gemc/detectors/eic/field/det1_solenoid_dual_v2_fieldBz.png

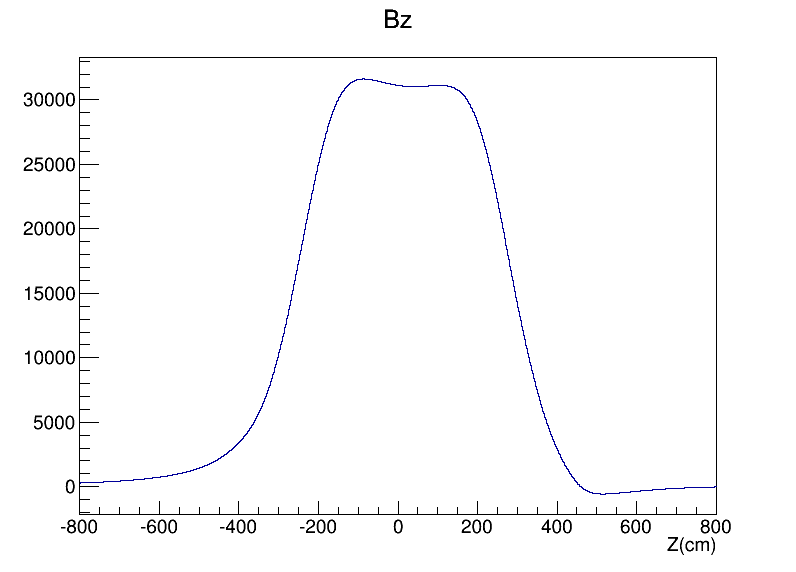
eic/field/det1_solenoid_dual_v2_fieldBz.png
