gemc/detectors/eic/field/det1_solenoid_dual_v2_fieldmap.png

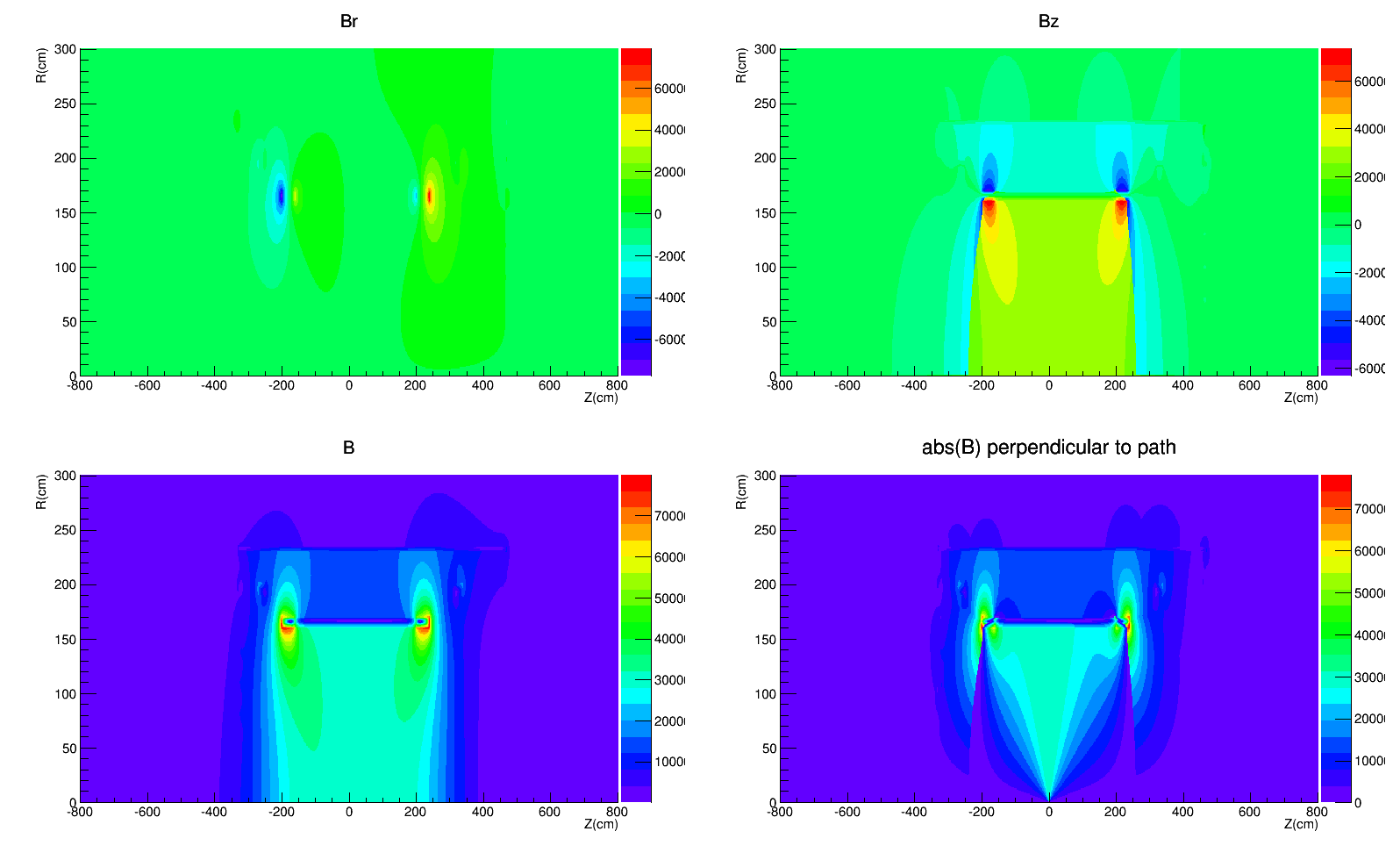
eic/field/det1_solenoid_dual_v2_fieldmap.png
