gemc/detectors/eic/field/det1_solenoid_dual_v9_fieldBz.png

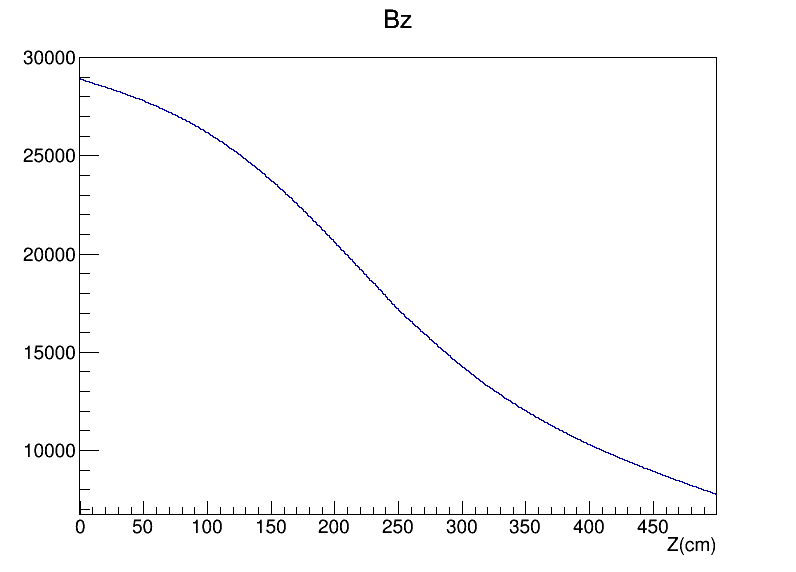
eic/field/det1_solenoid_dual_v9_fieldBz.png
