gemc/detectors/eic/field/det1_solenoid_dual_v9_fieldmap_log.png

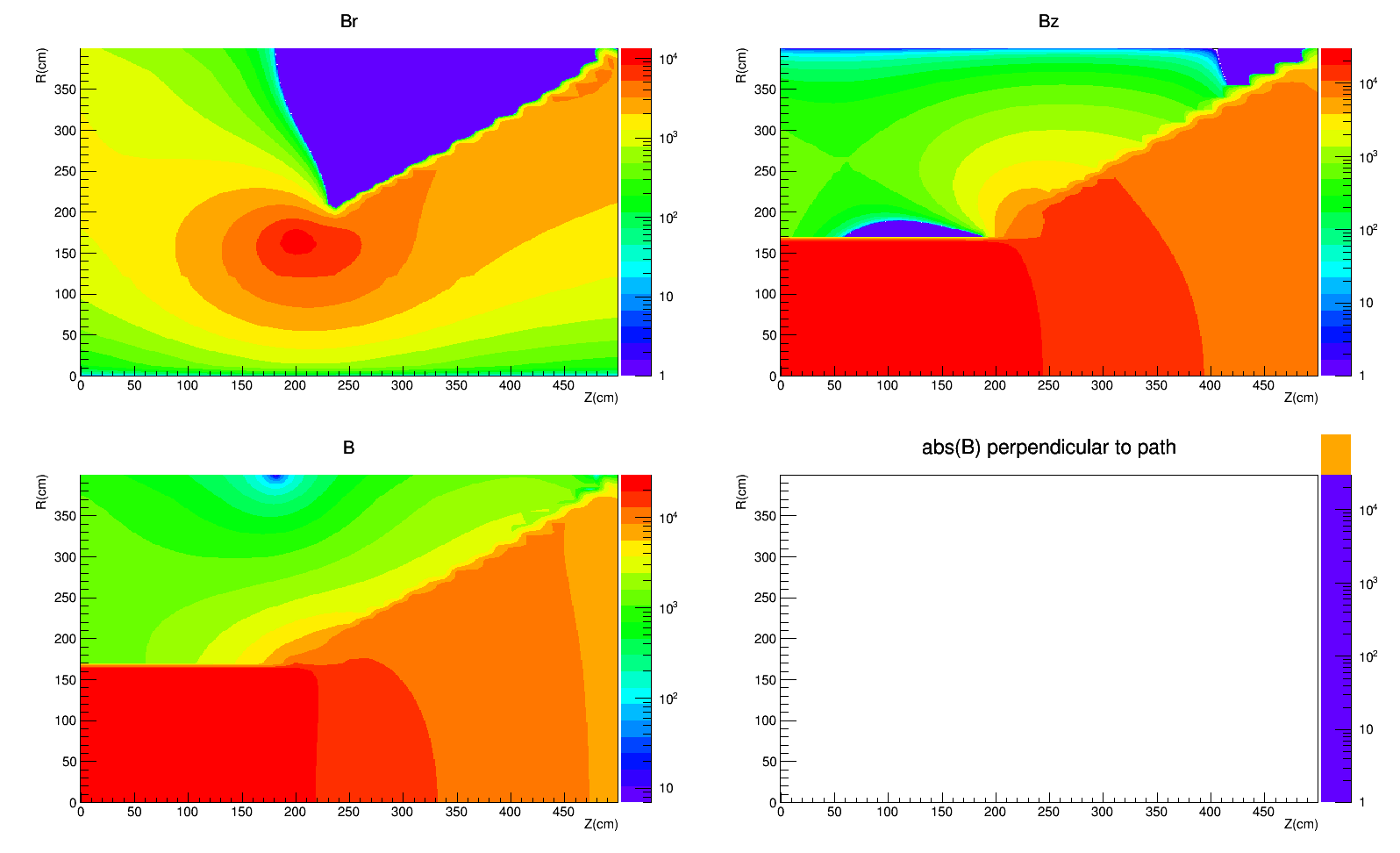
eic/field/det1_solenoid_dual_v9_fieldmap_log.png
