gemc/detectors/eic/field/det1_solenoid_hybrid_v1_fieldmap.png

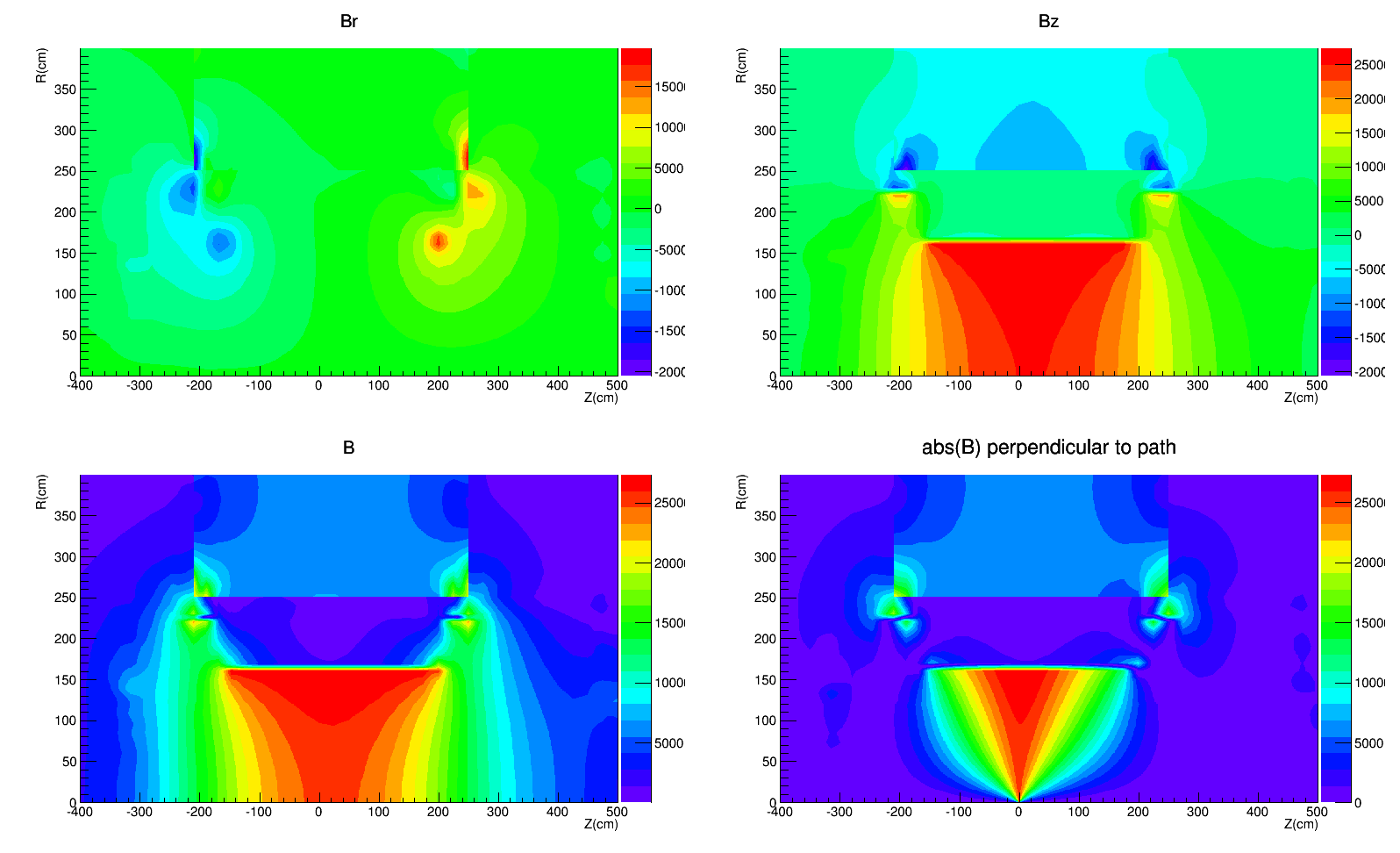
eic/field/det1_solenoid_hybrid_v1_fieldmap.png
