gemc/detectors/eic/field/det1_solenoid_hybrid_v1_fieldmap_log.png

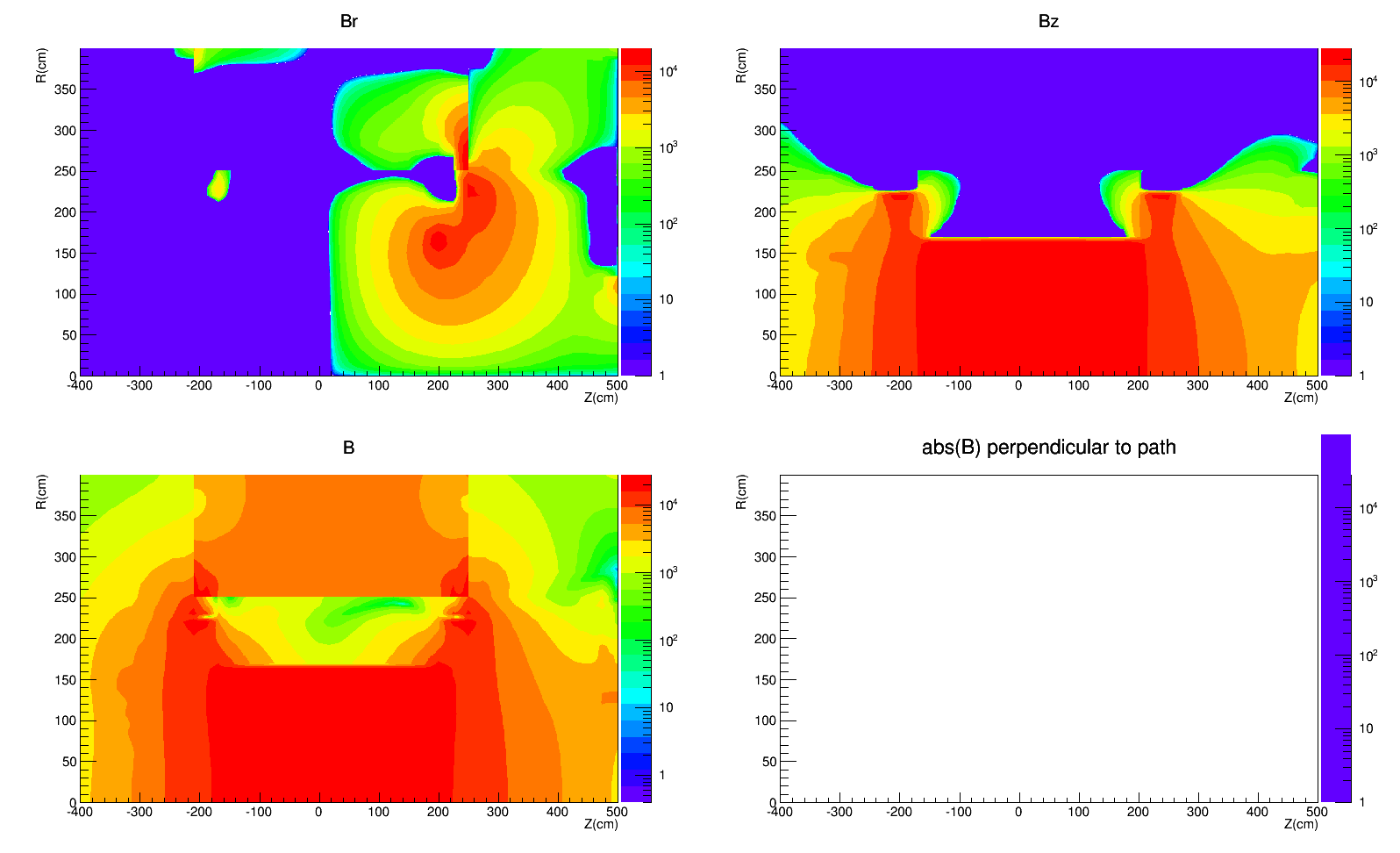
eic/field/det1_solenoid_hybrid_v1_fieldmap_log.png
