gemc/detectors/basic_examples/2_Working_with_materials/ex2_1_simple_det_materials/README.txt

#=======================================
#	README simple_det	materials
#=======================================

This folder contains one of the simplest possible projects:  a simple material in a beam. 
This simple case is used to show different ways of defining materials in gemc.  Unless using
a predefined GEANT4 element or NIST material directly in the detector definition, there will 
be a materials text file generated by materials.py for input to gemc.

The GEANT4 material database can be found at:
http://geant4.web.cern.ch/geant4/UserDocumentation/UsersGuides/ForApplicationDeveloper/html/apas06.html

The example should be able to run directly in gemc with the provided text input files and  the gcard option file using the command:
	gemc.command example.gcard

The example should be able to run directly in gemc with the provided text input files and  the gcard option 
file using the command:
	gemc.command example.gcard

If one wants to generate the text input files from the provided python scripts, the location of the python api files should be added to the PYTHONPATH. If installing via the DMG, add the following path for gemc-2.6:
export PYTHONPATH=$PYTHONPATH:/Applications/gemc-2.6.app/gemc.app/Contents/Resources/api/python
Adjust version number for a different gemc version

When this is done, generate the project files using:
	./example.py config.dat
WARNING:  this will overwrite the original project text files.
