gemc/detectors/basic_examples/3_Working_with_geometry/ex3_2_parameters_and_variations/ctof__materials_green.txt

        scintillator  |    ctof scintillator material  |     1.032  |         2  |                                          C 9 H 10  | none  | none  | none  | none  | none  | none  | none  |   -1  |   -1  |   -1  |   -1  |   -1  | none  
        scintillator  |    ctof scintillator material  |     1.032  |         2  |                                          C 9 H 10  | none  | none  | none  | none  | none  | none  | none  |   -1  |   -1  |   -1  |   -1  |   -1  | none  
        scintillator  |    ctof scintillator material  |     1.032  |         2  |                                          C 9 H 10  | none  | none  | none  | none  | none  | none  | none  |   -1  |   -1  |   -1  |   -1  |   -1  | none
