gemc/detectors/eic/geometry/det1_rich_dual_ionside/det1_rich_dual_ionside__materials_Original.txt

MAT_det1_rich_dual_ionside_aerogel  |     eic rich aerogel material  |      0.02  |         2  |                                          Si 1 O 2  |2*eV 2.5*eV 3*eV 3.5*eV 4*eV 7*eV  |1.02 1.02 1.02 1.02 1.02 1.02  |30*cm 30*cm 30*cm 30*cm 30*cm 30*cm  | none | none | none | none |-1  |-1  |-1  |-1  |-1  | none
             acrylic  |        eic rich lens material  |      1.19  |         3  |                                       C 5 H 8 O 2  |2.034*eV 3.181*eV 4.136*eV 4.13281*eV 6.19921*eV  |1.4902 1.5017 1.5017 1.5017 1.590  |5*cm 4.5*cm 4*mm 1*mm 0*mm  | none | none | none | none |-1  |-1  |-1  |-1  |-1  | none
           acrylic_a  |        eic rich lens material  |      1.19  |         3  |                                       C 5 H 8 O 2  |1.87855*eV 1.96673*eV 2.05490*eV 2.14308*eV 2.23126*eV 2.31943*eV 2.40761*eV 2.49579*eV 2.58396*eV 2.67214*eV 2.76032*eV 2.84849*eV 2.93667*eV 3.02485*eV 3.11302*eV 3.20120*eV 3.28938*eV 3.37755*eV 3.46573*eV 3.55391*eV 3.64208*eV 3.73026*eV 3.81844*eV 3.90661*eV 3.99479*eV 4.08297*eV 4.17114*eV 4.25932*eV 4.34750*eV 4.43567*eV 4.52385*eV 4.61203*eV 4.70020*eV 4.78838*eV 4.87656*eV 4.96473*eV 5.05291*eV 5.14109*eV 5.22927*eV 5.31744*eV 5.40562*eV 5.49380*eV 5.58197*eV 5.67015*eV 5.75833*eV 5.84650*eV 5.93468*eV 6.02286*eV 6.11103*eV 6.19921*eV  |1.4902 1.4907 1.4913 1.4918 1.4924 1.493 1.4936 1.4942 1.4948 1.4954 1.496 1.4965 1.4971 1.4977 1.4983 1.4991 1.5002 1.5017 1.5017 1.5017 1.5017 1.5017 1.5017 1.5017 1.5017 1.5017 1.5017 1.5017 1.5017 1.5017 1.5017 1.5017 1.5017 1.5017 1.5017 1.5017 1.5017 1.5017 1.5017 1.5017 1.5017 1.5017 1.5017 1.5017 1.5017 1.5017 1.5017 1.5017 1.5017 1.5017  |14.8495*cm 14.8495*cm 14.8495*cm 14.8495*cm 14.8495*cm 14.8495*cm 14.8495*cm 14.8495*cm 14.8495*cm 14.8495*cm 14.8495*cm 14.8495*cm 14.8495*cm 14.8495*cm 14.8495*cm 14.8495*cm 14.8495*cm 14.8494*cm 14.8486*cm 14.844*cm 14.8198*cm 14.7023*cm 14.1905*cm 12.3674*cm 8.20704*cm 3.69138*cm 1.33325*cm 0.503627*cm 0.23393*cm 0.136177*cm 0.0933192*cm 0.0708268*cm 0.0573082*cm 0.0483641*cm 0.0420282*cm 0.0373102*cm 0.033662*cm 0.0307572*cm 0.0283899*cm 0.0264235*cm 0.0247641*cm 0.0233451*cm 0.0221177*cm 0.0210456*cm 0.0201011*cm 0.0192627*cm 0.0185134*cm 0.0178398*cm 0.0172309*cm 0.0166779*cm  | none | none | none | none |-1  |-1  |-1  |-1  |-1  | none
MAT_det1_rich_dual_ionside_gas  |                  eic rich gas  |  0.005734  |         2  |                                           C 2 F 6  |2*eV 2.5*eV 3*eV 3.5*eV 4*eV 4.5*eV 5*eV 5.5*eV 6*eV 6.5*eV 7*eV  |1.000823 1.000823 1.000823 1.000823 1.000823 1.000823 1.000823 1.000823 1.000823 1.000823 1.000823  |10*m 10*m 10*m 10*m 10*m 10*m 10*m 10*m 10*m 10*m 10*m  | none | none | none | none |-1  |-1  |-1  |-1  |-1  | none
