gemc/detectors/eic/geometry/det1_beamline_pipe/det1_beamline_pipe__materials_Original.txt

det1_beamline_pipe_BeAl  |       det1_beamline_pipe_BeAl  |      2.16  |         2  |                             G4_Be 0.65 G4_Al 0.35  | none  | none  | none  | none  | none
