gemc/detectors/basic_examples/2_Working_with_materials/ex2_1_simple_det_materials/example__materials_original.txt

        scintillator  |         scintillator material  |     1.032  |         2  |                                          C 9 H 10  | none  | none  | none  | none  | none  | none  | none  |   -1  |   -1  |   -1  |   -1  |   -1  | none  
               water  |                water material  |     1.000  |         2  |                                           H 2 O 1  | none  | none  | none  | none  | none  | none  | none  |   -1  |   -1  |   -1  |   -1  |   -1  | none  
              my_air  |                  homemade air  |  0.001290  |         2  |                                 G4_N 0.7 G4_O 0.3  | none  | none  | none  | none  | none  | none  | none  |   -1  |   -1  |   -1  |   -1  |   -1  | none  
           my_lucite  |        plexiglass with optics  |      1.19  |         1  |                                 G4_PLEXIGLASS 1.0  |1.77*eV 6.2*eV  |1.5 1.5  | none  | none  | none  | none  | none  |   -1  |   -1  |   -1  |   -1  |   -1  | none
