gemc/detectors/basic_examples/4_Optical_properties/ex4_1_scintillation/example__materials_original.txt

              EJ_232  |Eljen Technologies EJ-232 plastic scintillator  |     1.032  |         2  |                                          C 9 H 10  |1.0*eV 2.0*eV 4.0*eV 6.0*eV  |1.40 1.40 1.40 1.40  |1000.*m 1000.*m 1000.*m 1000.*m  |0.5 0.5 0.5 0.5  |0.2 0.2 0.2 0.2  |0.8 0.8 0.8 0.8  |0.05 0.05 0.05 0.05  |8400.  |  2.0  |0.35*ns  |1.6*ns  |  0.8  | none
