gemc/detectors/basic_examples/4_Optical_properties/ex4_2_cerenkov_radiation/example__materials_original.txt

               water  |                 optical water  |      none  |         1  |                                        G4_WATER 1  |1.0*eV 6.0*eV  |1.33 1.33  |25.*m 25.*m  | none  | none  | none  | none  |   -1  |   -1  |   -1  |   -1  |   -1  | none
