gemc/detectors/basic_examples/4_Optical_properties/ex4_3b_optical_skin_surface/example__materials_original.txt

               glass  |                   pyrex glass  |      2.23  |         1  |                                  G4_Pyrex_Glass 1  |1.0*eV 6.0*eV  |1.47 1.47  | none  | none  | none  | none  | none  |   -1  |   -1  |   -1  |   -1  |   -1  | none  
      mirror_coating  |                mirror coating  |      2.70  |         1  |                                           G4_Al 1  |1.0*eV 6.0*eV  |1.2 1.2  | none  |0.97 0.97  | none  | none  | none  |   -1  |   -1  |   -1  |   -1  |   -1  | none  
              vacOpt  |vacuum with optical properties  |      none  |         1  |                                   G4_Galactic 1.0  |1.0*eV 6.0*eV  |1.00 1.00  |1000.*m 1000.*m  | none  | none  | none  | none  |   -1  |   -1  |   -1  |   -1  |   -1  | none
