gemc/detectors/basic_examples/4_Optical_properties/ex4_3c_optical_border_surface/example__materials_original.txt

              EJ_232  |Eljen Technologies EJ-232 plastic scintillator  |     1.032  |         2  |                                          C 9 H 10  |1.0*eV 2.0*eV 4.0*eV 6.0*eV  |1.0 1.0 1.0 1.0  |1000.*m 1000.*m 1000.*m 1000.*m  |0.5 0.5 0.5 0.5  |0.2 0.2 0.2 0.2  |0.8 0.8 0.8 0.8  |0.05 0.05 0.05 0.05  |8400.  |  2.0  |0.35*ns  |1.6*ns  |  0.8  | none  
              vacOpt  |vacuum with optical properties  |      none  |         1  |                                   G4_Galactic 1.0  |1.0*eV 6.0*eV  |1.00 1.00  |1000.*m 1000.*m  | none  | none  | none  | none  |   -1  |   -1  |   -1  |   -1  |   -1  | none  
              EJ_510  |EJ-510 TiO white reflective paint, Eljen Technologies  |       1.3  |         4  |                      Ti 6.71 C 11.2 H 22.5 O 19.0  |0.01*eV 60.0*eV  |2.7 2.7  |10.*m 10.*m  |1.0 1.0  |1.0 1.0  | none  | none  |   -1  |   -1  |   -1  |   -1  |   -1  | none
