gemc/detectors/atlas/cad/TRT.stl

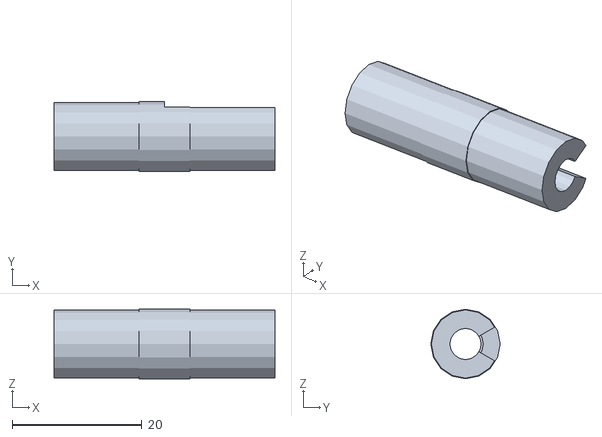
[picture p10: CAD file, 2016-07-22]
atlas/cad/TRT.stl
34.0 x 10.7 x 10.7
