gemc/detectors/clas12/ltcc/cad_cone/WC_L.stl

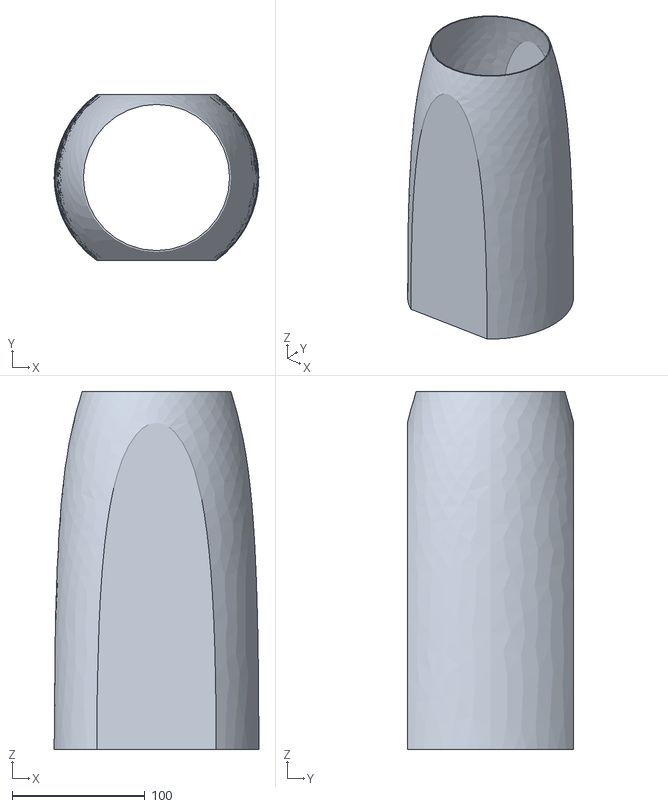
[picture p11: CAD file, 2017-02-22]
clas12/ltcc/cad_cone/WC_L.stl
154.0 x 125.1 x 269.4
