gemc/detectors/forFun/cad/enterprise.stl

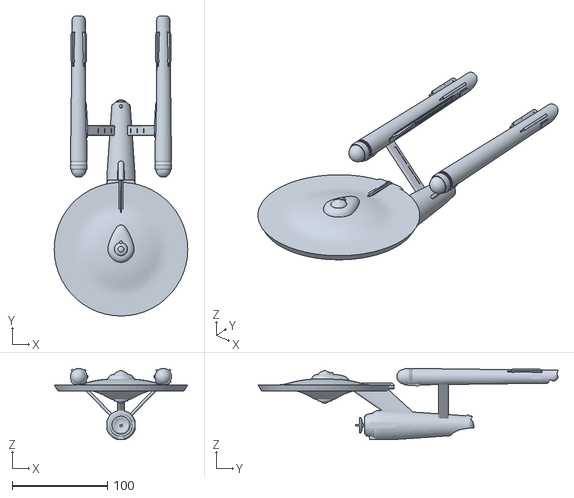
[picture p12: CAD file, 2016-07-22]
forFun/cad/enterprise.stl
140.0 x 314.4 x 74.7
