gemc/detectors/humanBody/cad/brain.stl

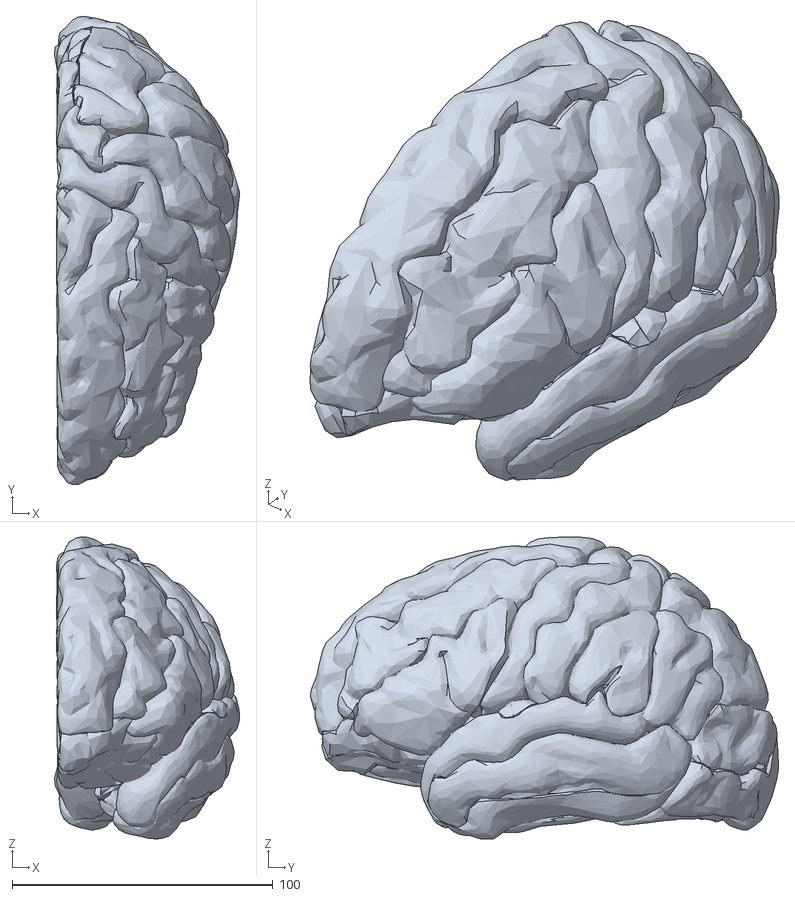
[picture p13: CAD file, 2016-07-22]
humanBody/cad/brain.stl
71.0 x 179.6 x 115.8
