gemc/detectors/atlas/cad/LargeOuterWheel.stl

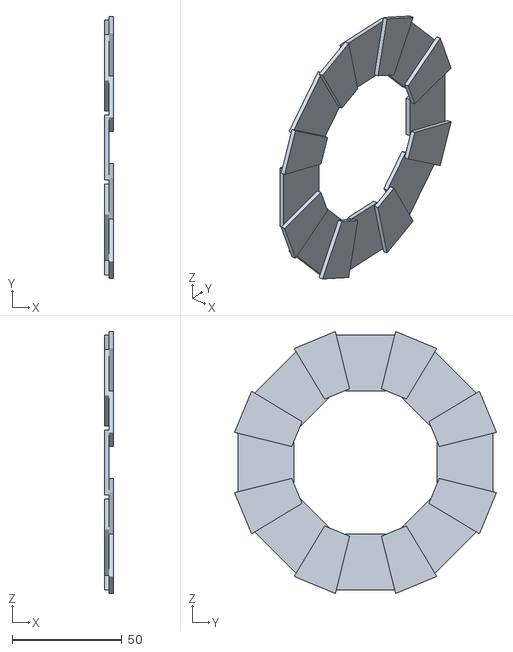
[picture p14: CAD file, 2016-07-22]
atlas/cad/LargeOuterWheel.stl
4.00 x 119.3 x 119.3
