gemc/detectors/forFun/cad/truck.stl

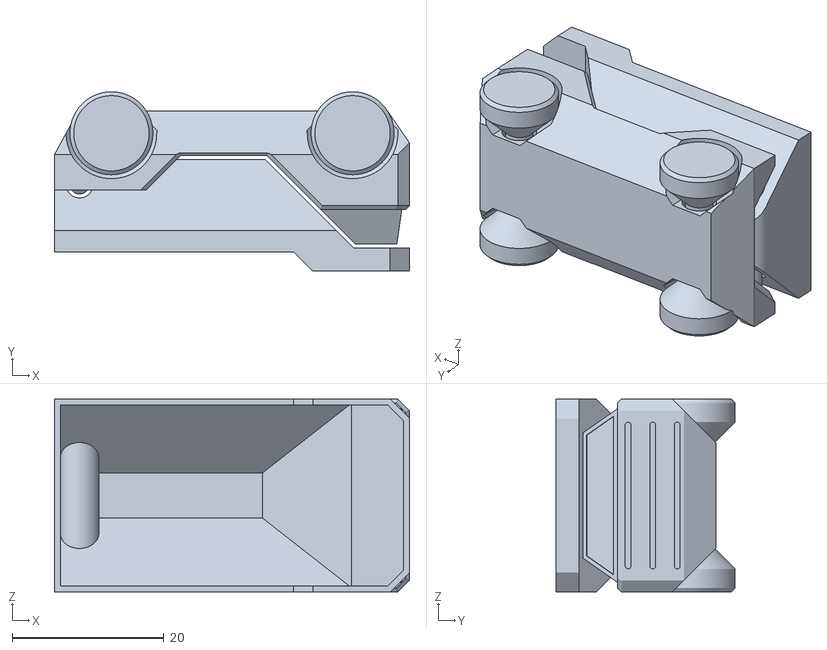
[picture p15: CAD file, 2016-07-22]
forFun/cad/truck.stl
46.7 x 23.6 x 25.4
