gemc/detectors/humanBody/cad/Lower_GI.stl

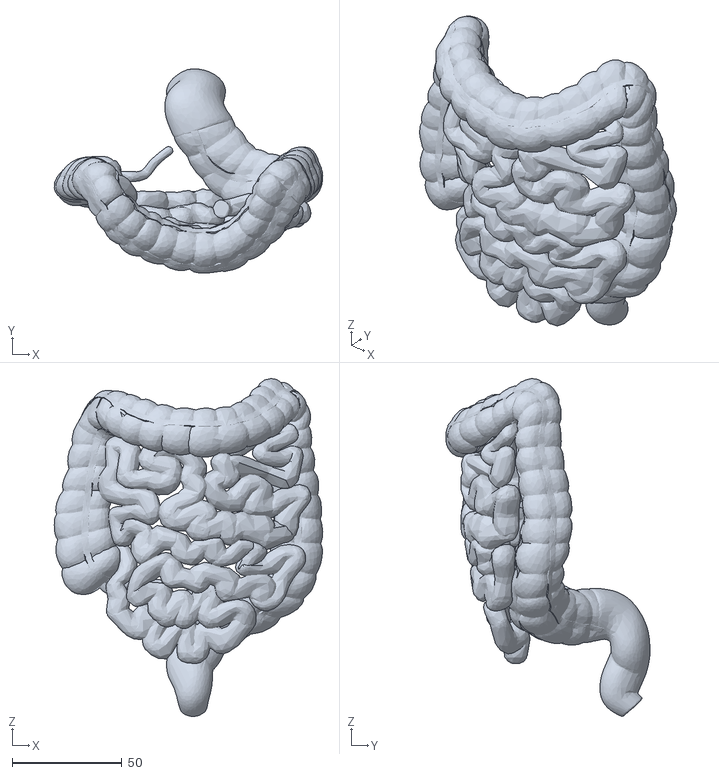
[picture p16: CAD file, 2016-07-22]
humanBody/cad/Lower_GI.stl
122.1 x 92.8 x 153.7
