gemc/detectors/atlas/cad/ForwardShield.stl

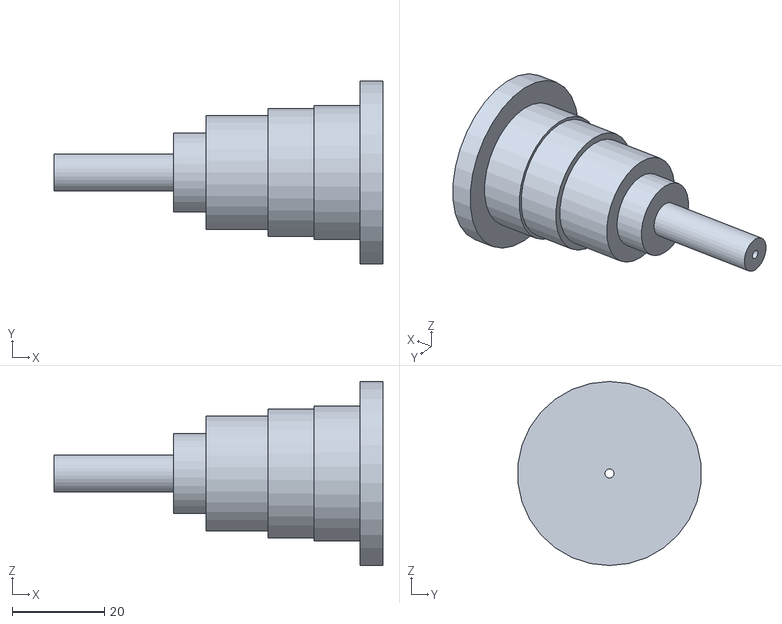
[picture p17: CAD file, 2016-07-22]
atlas/cad/ForwardShield.stl
71.5 x 39.8 x 40.0
