gemc/detectors/clas12/ltcc/cad_cone/WC_S_L11.stl

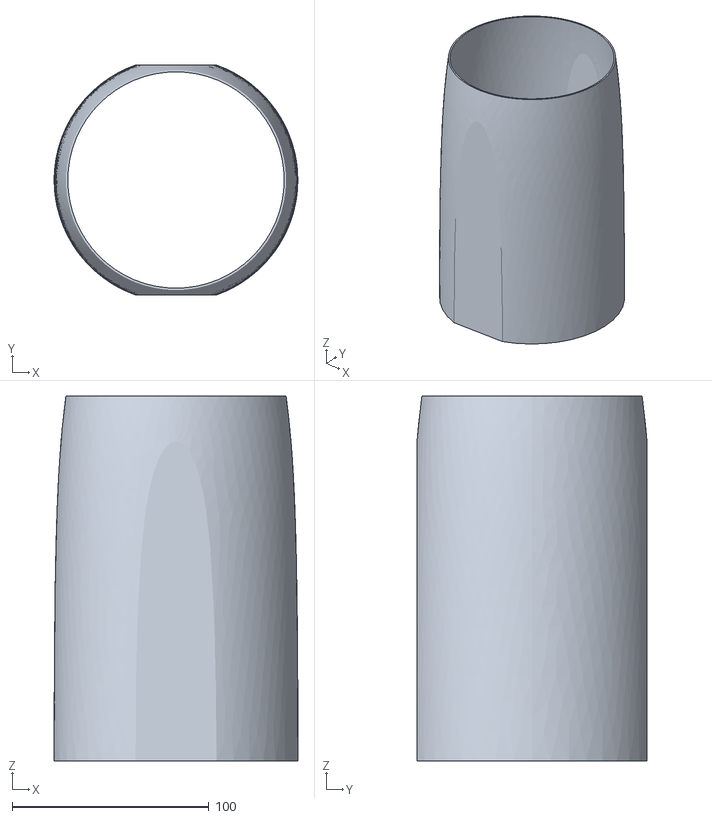
[picture p18: CAD file, 2017-02-22]
clas12/ltcc/cad_cone/WC_S_L11.stl
124.0 x 117.0 x 185.6
