gemc/detectors/forFun/cad/dragon.stl

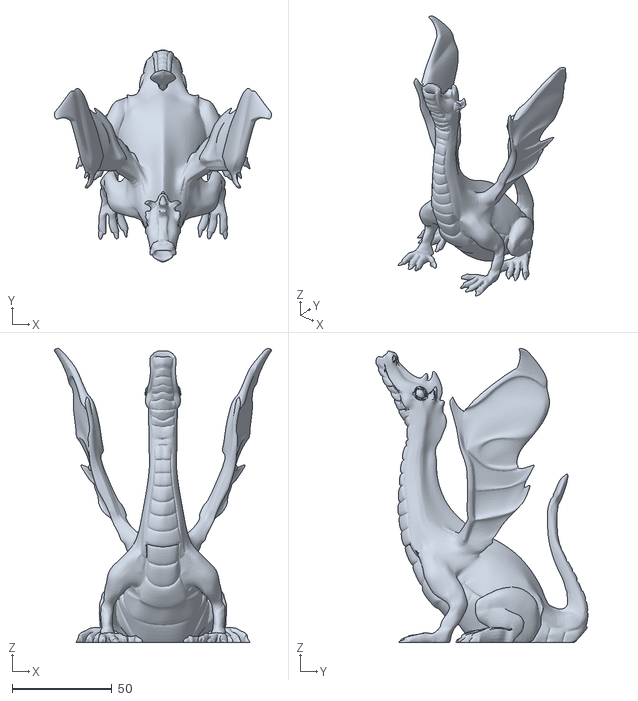
[picture p19: CAD file, 2016-07-22]
forFun/cad/dragon.stl
108.8 x 106.3 x 147.2
