gemc/detectors/humanBody/cad/Upper_GI.stl

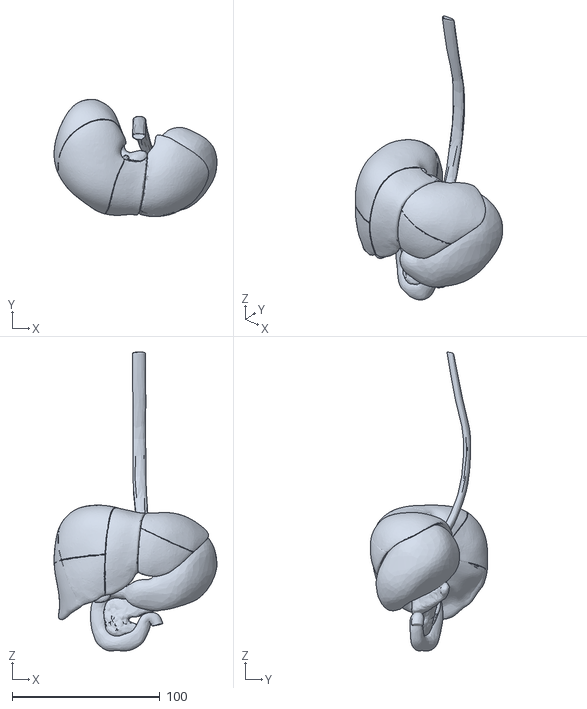
[picture p20: CAD file, 2016-07-22]
humanBody/cad/Upper_GI.stl
110.3 x 79.5 x 202.4
