gemc/detectors/atlas/cad/Toroid.stl

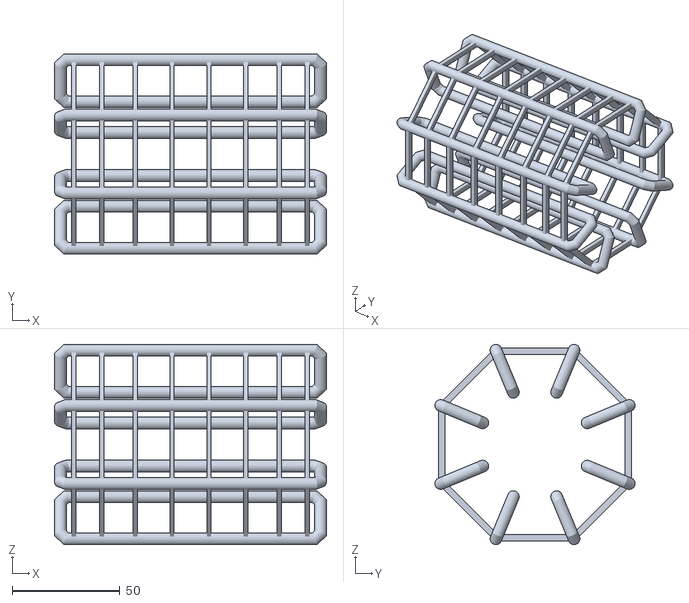
[picture p21: CAD file, 2016-07-22]
atlas/cad/Toroid.stl
126.3 x 93.0 x 93.0
