gemc/detectors/clas12/ltcc/cad_cone/WC_S_L111.stl

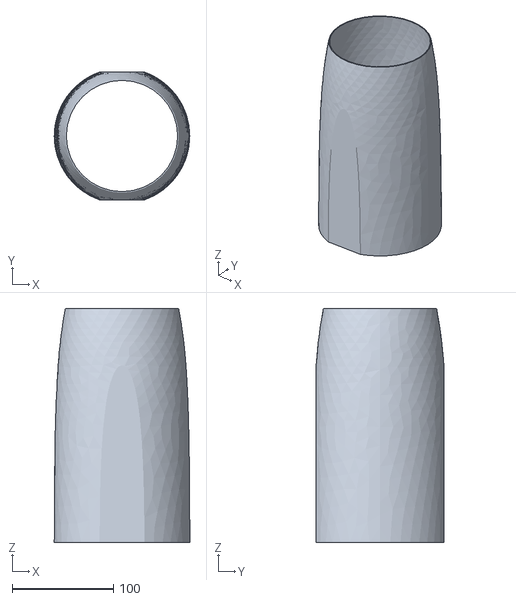
[picture p22: CAD file, 2017-02-22]
clas12/ltcc/cad_cone/WC_S_L111.stl
134.0 x 126.5 x 231.3
