gemc/detectors/humanBody/cad/heart.stl

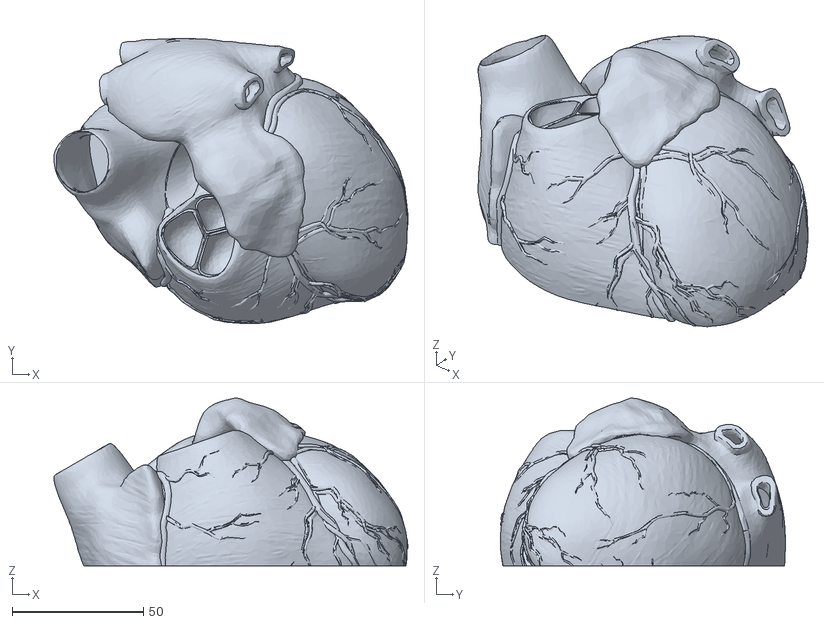
[picture p23: CAD file, 2016-07-22]
humanBody/cad/heart.stl
134.9 x 108.7 x 64.0
