gemc/detectors/atlas/cad/SmallBarrel.stl

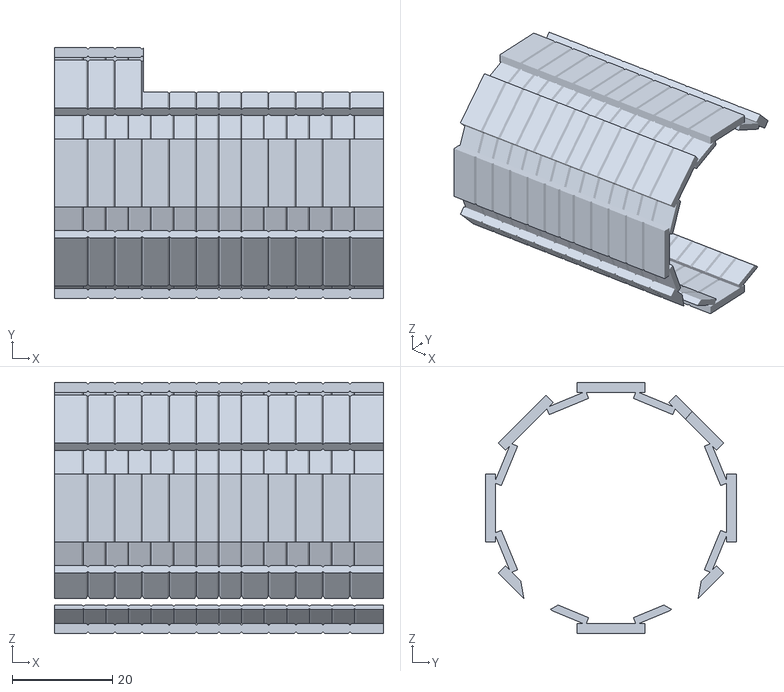
[picture p24: CAD file, 2016-07-22]
atlas/cad/SmallBarrel.stl
65.5 x 50.0 x 50.0
