gemc/detectors/atlas/cad/HEC.stl

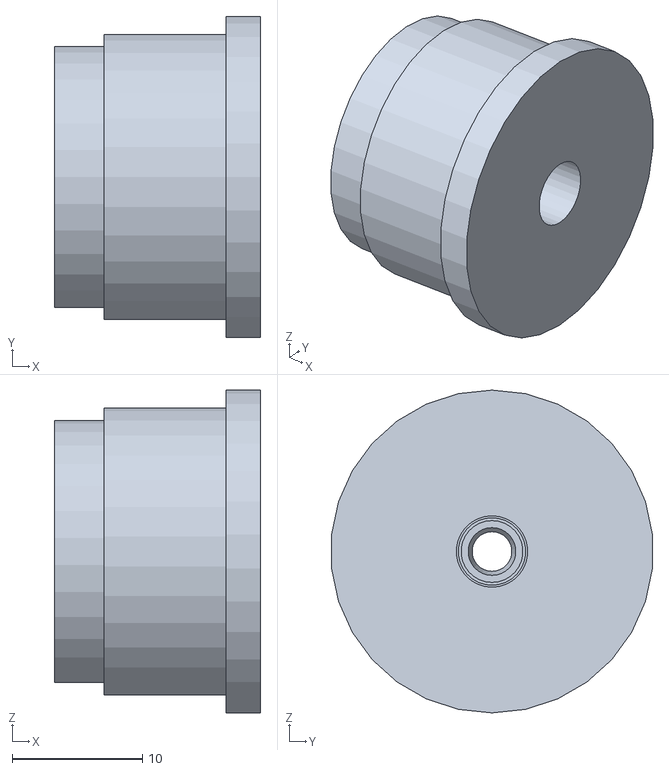
[picture p25: CAD file, 2016-07-22]
atlas/cad/HEC.stl
15.8 x 24.6 x 24.8
