gemc/detectors/(threads)

Thread 1 (2015-07-31):

EC Geometry bug?

forcar, 2015-07-31:
The attached plot shows a missing lead layer between the last two scintillators.  Also the last scintillator (39) does not follow the truncated pyramid geometry and looks almost identical to 38.  In between 38 and 39 there is no lead.  It may be the lead sequence is staggered upward since in EC there is no lead in front of the first scintillator.  I checked Gerry Gilfoyle's old talks and he had it correct in the original GEMC.
- Cole Smith

Addendum: Found bug in detectors/clas12/ec/geometry.pl in build_scintlayers subroutine where the loop index $i is not initialized to 1 for sectors 2-6.  This caused the first scintillator to be inserted with i=40, in effect putting scintillator 1 just below scintillator 39 as seen in the GEMC view (below, bottom).  This also explains why the average energy in the U strips was smaller than V or W since 20% of the energy was missing (plot just below left=U right=W).

I propose putting the statement "my $i = 1;" at line 368 in build_scintlayers.
- Cole Smith

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

maureeungaro, 2015-07-31:
Testing "New Issue" comments feature.

This looks like a bug in the geometry. Please modify as needed.

Closed 2015-08-02.

Thread 159 (2020-07-02):

ATOF and AHDC geometry implementation for A Low Energy Recoil Tracker (ALERT)

Viktoriya89, 2020-07-02:
This issue is to share the implementation of ALERT detector geometry. The detector consists of 2 parts: the hyperbolic drift chamber (AHDC) and time of flight scintillators (ATOF). Now, all active cells geometry is implemented. Any inert material structure can be added later using groovy or perl scripts.

maureeungaro, 2020-07-06:
merged

Closed 2020-07-06.

Thread 237 (2024-09-04):

overlap in the FMT geometry

raffaelladevita, 2024-09-04:
An overlap between layer1 and the mother volume is clearly visible in the rggf_spring2020 variation

maureeungaro, 2024-09-04:
making the mother volume 1.9 mm bigger fixes the mother volume overlap. However I see some additional overlaps , some quite significant like this one.

          Overlap is detected for volume FMT_outerPeek3:1 (G4Tubs)
          with FMT_Gas23:1 (G4Tubs) volume's
          local point (186.574,-40.8816,0.573267), overlapping by at least: 1.92673 mm

Will wait for Raffa's approval of the mother dimension increase. The other overlaps should be looked at by FMT group.

maureeungaro, 2024-09-04:
Increasing the gas volumes fixes these 'major' overlaps.  Some sub-microns overlaps persists but it may be geant4 precision issues of volumes very close together.

Thread 255 (2024-11-11):

Complete geometry vs run number for CLAS12 detectors

maureeungaro, 2024-11-11:

maureeungaro, 2024-11-14:
Pending CAD API  issue #250
