gemc/detectors/(commit log)

2015-07-31 ported detectors from svn
    [bst__parameters_original.txt, cnd__parameters_original.txt, ctof__parameters_original.txt, ec__parameters_original.txt, ftof__parameters_original.txt, geometry.parm, htcc__parameters_original.txt, micromegas__parameters_original.txt]
2015-08-28 Update micromegas__parameters_original.txt
    New geometry for fmt et bmt detectors
    [micromegas__parameters_original.txt]
2015-08-28 Update materials.pl
    update for new fmt and bmt geometry
2015-11-19 remove SL1,2,3 in gcard. production cut in hit. starting angle in geometry. no FMT in the perl script
    [micromegas__parameters_original.txt]
2015-11-24 added bubble setup
    [bubble__parameters_original.txt]
2015-11-24 started bubble template
    [bubble__parameters_original.txt]
2015-11-24 collimator + radiator added
    [bubble__parameters_original.txt]
2015-11-30 ”comment”
    [bubble__parameters_original.txt]
2015-12-01 Updated geometry
    [bubble__parameters_original.txt]
2015-12-02 added sensitivity, radiator flux detector, fixed radiator, addeed n2o inside chamber, added vacuum inside radiator
2015-12-16 Updated geometry, add LUMI event
    [bubble__parameters_original.txt]
2016-01-07 1/7/15 - added mount nose to torus - both phys and eng. design - draft of physicist design for shielding with and w/o FT finalized
2016-01-08 changes to forward carriage volume to accomodate dc volume growth for baseplates
2016-01-11 1/11/16 - torus is greatly simplified - some numbers will need some minor tweaks. - fixed overlaps with forward carriage volume as well
2016-01-14 added torus mount total length
2016-01-21 added dimension to missing first par of plates
2016-01-21 fixed vacuum beamline in case of FT
2016-01-22 mount dimensions modified according to Bob's email. mount outer shield added
2016-01-22 beampipe is 3.175mm thick up to the downstream torus nose end
2016-01-28 changed on 1/26/16: M. Mestayer. Fixed staggering. The first layer of sense wires (ilayer=1)
2016-01-29 modified FT "NotUsed..." variations removing tracker and added one beamline vacuum pipe variation with 50 mm OD for compatibility with ft NotUsedWithInnerShield
2016-01-29 improved scripts, added material to main script. added bst in gcard
2016-02-01 added bst.pl script to do geometry, material, banks and hits
2016-02-02 adding end plates, beamline macro, and doing materials changes
2016-02-02 formatting changes, and making all volumes solids instead of wireframe
2016-02-08 bst:
    - code clean ups
    cnd:
    - added cnd.pl script to do geometry, material, banks and hits
2016-02-08 - added ctof.pl script to do geometry, material, banks and hits - improved readmes for bst cnd ctof
2016-02-08 - more code clean up - added ec.pl script to do geometry, material, banks and hits
2016-02-08 - added ftof.pl script to do geometry, material, banks and hits
2016-02-11 new geometry and related scripts for Hall A dump and Catania setup for bg measurements
2016-02-11 2/11/16 - added htcc.pl script to do geometry, material, banks and hits
2016-02-11 - added pcal.pl script to do geometry, material, banks and hits
    [pcal__parameters_original.txt]
2016-02-29 - finalized micromegas.pl script to do geometry, material, banks and hits
2016-02-29 2/29/16 - added targets.pl script to do geometry, material, banks and hits - added elaborate geometry from omairsalam
2016-03-01 3/1/16 - added magnets.pl to build both solenoid and torus geometry - removed obsolete ftm as now it's inside FT
2016-03-04 adding Edep in bms digitization output
2016-03-07 - relaxing magnets.pl to accept one argument so it is consistent with the other scripts
2016-03-17 added root macros to check wire efficiency and smeearing
2016-04-04 only printing variations FTon/off
2016-04-04 print parameters values for position and rotation of panel Volumes
2016-04-05 added materials, crystal rotations
2016-04-08 removed par file
    [pcal__parameters_original.txt]
2016-04-08 replaced pars with the java version
    [ftof__parameters_original.txt]
2016-04-15 reducing additional radius on support and shield to avoid overlaps with the solenoid
2016-05-10 New version of the RICH geometry. It has the most updated information on geometry and position of the elements relevant for the direct-light case. # Please enter the commit message for your changes. 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
    [rich__parameters_original.txt]
2016-05-10 typo fo fc carriage name
2016-05-10 switch dc.gcard to java variation
2016-05-11 Added in geometry the files "frontal_system.pl" and "pmt.pl", that were missing in the previous stage.
2016-05-11 Fixed the name of "carbon fiber" in materials.pl - and reproduced the txt files.
2016-05-19 moved mucal at 60cm
2016-06-09 ftof loop over volumes is defined by perl script now
    [ftof__parameters_original.txt]
2016-06-10 ctof geometry changed to 48 paddles
    [ctof__parameters_original.txt]
2016-07-07 removed materials from cpp factory
2016-07-22 added cad and gdml example import. added atlas cad import example. added forFun example
    [ForwardShield.stl, HEC.stl, LargeOuterWheel.stl, SmallBarrel.stl, TRT.stl, Toroid.stl, dragon.stl, enterprise.stl]
2016-07-22 added human body example
    [Lower_GI.stl, Upper_GI.stl, brain.stl, heart.stl]
2016-07-28 7/28/16 - added cad directory with stl files for scintillators and light guides - added cad.gxml to assign sensitivity to the paddles. Positions / rotations from engineering frame added - modified hi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
    [lgd01.stl, lgd02.stl, lgd03.stl, lgd04.stl, lgd05.stl, lgd06.stl, lgd07.stl, lgd08.stl]
2016-07-28 added upstream light guides
    [lgu01.stl, lgu02.stl, lgu03.stl, lgu04.stl, lgu05.stl, lgu06.stl, lgu07.stl, lgu08.stl]
2016-07-28 two variations created, original and cad, so both can be used in the gcard
2016-08-09 getting local position in cad paddle
2016-08-22 michel garcon changes on BMT
    [micromegas__parameters_original.txt]
2016-09-02 Added sensor active zones and dead zones for SVT.
2016-09-02 BST: Added output of perl scripts for version "java".
    [bst__parameters_java.txt]
2016-09-12 added sensor active and dead zones still need to work out hit definition
2016-09-16 Removed sensor active and dead zones Added local copy of SVTGeometry-coatjava-2.4.jar v0.2.3
    [bst__parameters_java.txt]
2016-09-22 fix DC gcard typo CArriage->Carriage
2016-09-30 added cad model of the beamline
    [cone-tip.stl, flange-assembly.stl, inner-assembly.stl, innerShieldAndFlange.stl, lead-shield.stl, lifting-plate.stl, main-cone.stl, nut1.stl]
2016-10-05 moved cad.gxml in files directory
2016-10-06 FT inner shield and mount mesh fixed. It was STP format, new IGS used instead
    [TUNGSTEN_PIPE_MZ.igs, taggerInnerShield.stl]
2016-10-10 preserving original micromegas configuration
    [micromegas__parameters_michel.txt, micromegas__parameters_original.txt]
2016-10-10 moved cad into cadBeamline dir
2016-10-10 moved files into cad dir
    [Lower_GI.stl, Upper_GI.stl, brain.stl, dragon.stl, enterprise.stl, heart.stl, truck.stl]
2016-10-18 michel new files
    [micromegas__parameters_michel.txt]
2016-10-27 added new rotation angles about z axis for shields, updated WCs and pmts angles
2016-10-27 added smaller cylinders inside the pmts as light stoppers, fixed the segment number in identifier, changed the colors of shields and WCs
2016-11-14 backup for coatjava v2.4 version
    [bst__parameters_java.txt]
2016-11-21 GXML class and CTOF CAD import
2016-11-21 export primitives to STL files
2016-11-22 Final relabelling of CND sector-layer-components
    [cnd__parameters_original.txt]
2016-11-28 SVT: added passive materials to geometry_java.pl
    [bst__parameters_java.txt]
2016-11-28 SVT switched to all sectors and enabled modules
2016-12-05 latest geometry from Michel Garcon
    [micromegas__parameters_michel.txt]
2016-12-06 Fixed parameter file errors
    [cnd__parameters_original.txt]
2016-12-08 SVT fixed bug with pads
    [bst__parameters_java.txt]
2016-12-26 updated C4F10 CO2 and N2 optical paramters between 170 nm and 650 nm. Quartz pmt QE values are replaced with p-Terphenyl pmt QE values
2017-01-18 switch to coatjava 3.0
2017-01-23 PMTs, Winston Cones, Shields, Cylindrical mirrors are moved into the LTCC sectors. To fit the LTCC geometry into LTCC box shields have been shrunk and replaced to their correct positions (dz_d parame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
    [S1-BB.stl, S1-BLB.stl, S1-BRB.stl, S1-BW.stl, S1-LW.stl, S1-RW.stl, S1-TB.stl, S1-TLB.stl]
2017-02-14 switch DC to JCSG
2017-02-15 SVT switch to COATJAVA 3.0
2017-02-21 Winston cones were made in AUTOCAD and placed in the simulation. Code cleanep up. Calculations for positions and rotations are in geo_calculations.C script. Some parameters added/removed. It is essen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
    [WC_S_L11.stl, WC_S_L110.stl, WC_S_L111.stl, WC_S_L112.stl, WC_S_L113.stl, WC_S_L114.stl, WC_S_L115.stl, WC_S_L116.stl]
2017-02-28 cones are replaced in ltcc sectors, cone names are modified, geo_calculations script creates a tsv file that the variables' values are written on
    [WC_S1_L1.stl, WC_S1_L10.stl, WC_S1_L11.stl, WC_S1_L12.stl, WC_S1_L13.stl, WC_S1_L14.stl, WC_S1_L15.stl, WC_S1_L16.stl]
2017-03-08 copies of the cones were made
    [WC_L.stl, WC_M.stl, WC_S.stl, WC_S1_L10.stl, WC_S1_L12.stl, WC_S1_L14.stl, WC_S1_L15.stl, WC_S1_L16.stl]
2017-03-24 1st check into eic detector
    [det1_beamline_magnet__parameters_Original.txt, det1_compton_eledownstream__parameters_Original.txt, det1_tagger_eledownstream__parameters_Original.txt, ion_beam_env_ds_22jun16.xls, meic_v12_det_reg_elem.13dec13.xls, meic_v15d_det_reg_elem.10Jun15.xls, meic_v15d_det_reg_elem.12mar15.xls, meic_v15e_det_reg_elem.3Dec15.xls]
2017-04-12 fixed mirror sensitivity
    [ltcc__parameters_original.txt]
2017-05-05 Slight modifications of the bmt geometry
    [micromegas__parameters_michel.txt]
2017-05-08 organized cad.gxml files according to dir
2017-06-08 putting taggerInnerShield in the correct position (is a separate cad volume)
2017-06-20 fixed cad gxml with correct hierarchy. skipped the 3 original cones right copies
2017-06-27 Add adc info in FMT bank
2017-07-05 added torus cad files
    [Beamline.stl, BoreShield.stl, CenterTube.stl, DownstreamShieldingPlate.stl, DownstreamVacuumJacket.stl, Hub001.stl, Plate1.stl, Plate2.stl]
2017-07-05 using javacad instead of cad
    [lgd01.stl, lgd02.stl, lgd03.stl, lgd04.stl, lgd05.stl, lgd06.stl, lgd07.stl, lgd08.stl]
2017-07-05 added geometry including cads for clas12
    [lgd01.stl, lgd02.stl, lgd03.stl, lgd04.stl, lgd05.stl, lgd06.stl, lgd07.stl, lgd08.stl]
2017-07-05 no javacad, that one is created
    [lgd01.stl, lgd02.stl, lgd03.stl, lgd04.stl, lgd05.stl, lgd06.stl, lgd07.stl, lgd08.stl]
2017-07-05 remove files not needed, make some pipe visiable and hide some virtual planes
    [det1_compton_eledownstream__parameters_Original.txt]
2017-07-07 moving cad volumes for FTOFF in a separate directory
    [cone-tip.stl, flange-assembly.stl, inner-assembly.stl, innerShieldAndFlange.stl, lead-shield.stl, lifting-plate.stl, main-cone.stl, nut1.stl]
2017-07-07 copying the STL file instead of making links
    [flange-assembly.stl, innerShieldAndFlange.stl, lifting-plate.stl, main-cone.stl, nut1.stl, nut2.stl, nut3.stl, nut4.stl]
2017-07-07 fixing position for FTON
    [lifting-plate.stl]
2017-07-10 added DS torus shield
    [ShieldDSadapter.stl, ShieldDSlead.stl, ShieldDSleadbase.stl]
2017-07-10 added correct material for torus parts
2017-07-12 fixed materials for some cad volumes
2017-07-14 added adc variable
2017-08-08 created a new script for the frame
2017-08-09 deleted the unnecessary frame files since the copies are made
    [S2-BB.stl, S2-BLB.stl, S2-BRB.stl, S2-BW.stl, S2-LW.stl, S2-RW.stl, S2-TB.stl, S2-TLB.stl]
2017-08-09 added the subroutines for cones, cylindrical mirrors, frame and shields
2017-08-09 added the line to load cad files of the frame
2017-08-10 placed ltcc sector 15 cm downstream
2017-08-11 building LTCC frame not under comment anymore
2017-08-11 added clas8 bullet
    [downstreamTube.stl]
2017-08-14 frames are sst. No need for sector 3 as it's the one from CAD
2017-08-17 CTOF geometry mofidication * removed upstream lightguides * moved GXML as a module to api directory (it will be the same and used for multiple future CAD detectors, e.g. RICH)
2017-08-17 removed flange assembly. added apex volume
    [flange-assembly.stl]
2017-08-17 removed downstream tube
    [downstreamTube.stl]
2017-08-18 added new vacuum line. numbers to be finalized
    [apex.stl]
2017-08-18 removed obsolete cad models
    [Beamline.stl, ShieldDSadapter.stl, ShieldDSlead.stl, ShieldDSleadbase.stl]
2017-08-21 new apex from cyril. added lead inside apex
    [apex.stl]
2017-08-21 removing obsolete files
    [micromegas__parameters_original.txt]
2017-08-21 fixxed typo in material
2017-08-22 fixed ltcc frame mother to fc
2017-08-22 fixed cad frame mother to fc
2017-08-29 added target cad elements
    [TargetAlWindowD.stl, TargetAlWindowU.stl, TargetBaseTubeTorlon.stl, TargetEndCapKapton.stl, TargetFoam.stl, TargetFoam2.stl, TargetFoam3.stl, TargetVacuumTubeAl.stl]
2017-08-30 target from cad, embedded in vacuum container, lh2 cell
2017-08-30 smaller target enclosure. vacuum line in the shield starting 1mm downstream of target vac extension
2017-08-30 smaller target enclosure. vacuum line in the shield starting 1mm downstream of target vac extension; removed fton2 variation
2017-08-31 vacuum extension is carbon fiber. added material
2017-09-07 change in frame material
2017-09-11 materials are not transparent
2017-09-11 new target, no transparency in MM
    [TargetVacuumTubeAl.stl]
2017-09-20 added adjuster. retessalating step files
    [innerShieldAndFlange.stl, nut1.stl, nut2.stl, nut3.stl, nut4.stl, nut5.stl, nut6.stl, nut7.stl]
2017-09-20 added adjusters
    [adjuster1.stl, adjuster2.stl, adjuster3.stl]
2017-09-22 new stl file for FTOff configuration as well
    [innerShieldAndFlange.stl, nut1.stl, nut2.stl, nut3.stl, nut4.stl, nut5.stl, nut6.stl, nut7.stl]
2017-09-22 more precise inner shield
    [innerShieldAndFlange.stl]
2017-09-29 new stl for inner shield in tagger; moved outer flange upstream to avoide overlap with FC
    [taggerInnerShield.stl]
2017-09-29 step file backup up in another location
    [TUNGSTEN_PIPE_MZ.igs]
2017-10-10 added downstream element from CAD model. modifying vacuum line and adding connecting element from CAD model
    [DSShieldBackAss.stl, DSShieldBackCover.stl, DSShieldBackLead.stl, DSShieldFlange.stl, DSShieldFlangeAttachment.stl, DSShieldFrontAss.stl, DSShieldFrontCover.stl, DSShieldFrontLead.stl]
2017-10-12 added definitions for FTOff. Removed lifting plate and window support, not needed
    [lifting-plate.stl, windowSupportUpstreamPipe.stl]
2017-10-12 using latest FT Inner shield for OFF configuration as well
    [taggerInnerShield.stl]
2017-10-13 in FT, the hit time window is rised from 4ns to 400 ns, this is for account pileup in mode1 output, an in the ctof banks in the identifier a new element is added order which should define which PMT i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
2017-10-18 making FMT inner radius bigger to accomodate target
    [micromegas__parameters_michel.txt]
2017-11-02 un necesarry files are deleted
    [lgd01.stl, lgd02.stl, lgd03.stl, lgd04.stl, lgd05.stl, lgd06.stl, lgd07.stl, lgd08.stl]
2017-11-02 Secondary files from ftof are removed
    [ftof__parameters_java.txt]
2018-02-01 added several materials
2018-02-25 included materials for Run Group C Polarized Target (PolTarg)
2018-02-25 descritor file for CAD drawing
2018-02-25 Helium cooling liquid for Polarized target
    [LHeVolume_29.stl]
2018-02-25 PCTFE holder for target cells
    [InsertBath_6.stl]
2018-03-01 saving various changes for different materials
2018-03-02 fixed dc material
2018-03-20 Update rtpc.pl
    Changed z_half from 200 mm to 192 mm (4 total pads less).
2018-05-22 Add files via upload
    No Boid STL files
    [InsertBath_NoVoid_6.stl, LHeVolume_NoVoid_29.stl]
2018-06-07 update on micromegas geometry and 8-mm upstream shift for bmt and fmt
    [micromegas__parameters_michel.txt]
2018-07-03 added W shied 51 microns and neoprene shield 2.7mm outside of svt
2018-07-05 added LTCC nose from model
    [BottomPlate.stl, Epoxy.stl, FrontPlate.stl, Mount.stl, NFrame.stl, Nose.stl]
2018-07-23 added magnets and dc in the gcard
2018-10-09 fixing atlas example
    [ForwardShield.stl, HEC.stl, LargeOuterWheel.stl, SmallBarrel.stl, TRT.stl, Toroid.stl]
2018-10-30 added ctof shield configurations, 1,2,3 mm
2018-11-30 added 0.1 conf
    [TargetFoam.stl]
2018-12-03 front foam w/o the original nose
    [TargetFoam.stl]
2018-12-11 Delete LHeVolume_NoVoid_29.stl
    removed LHe Volume for now
    [LHeVolume_NoVoid_29.stl]
2018-12-11 Update cad.gxml
    commented out LHe volume
2019-02-24 Add files via upload
    Adding the necessary files to implement the EG2p nuclear targets assembly in gemc.
    [cellAlwindow.stl, cellendcap.stl, endcapAlwindow.stl, firstRohacellSpacer.stl, firsttargframe.stl, secondRohacellSpacer.stl, secondtargframe.stl, targetContainer.stl]
2019-03-03 old lh2 and ld2 to become obsolete, using cad model for those
2019-03-11 solenoid material is copper not iron
2019-07-03 added devel case for coatjava
2019-07-10 finalized ltcc variations for different run period. also fixed PMT thickness and mirrors materials
2019-07-10 rich sector 4 geometry added
    [Aluminum.stl, CFRP.stl, Layer_201_component_1.stl, Layer_201_component_10.stl, Layer_201_component_11.stl, Layer_201_component_12.stl, Layer_201_component_13.stl, Layer_201_component_14.stl]
2019-07-11 remove rich geometry txt files produced by geometry factory
    [Aluminum.stl, CFRP.stl, Layer_201_component_1.stl, Layer_201_component_10.stl, Layer_201_component_11.stl, Layer_201_component_12.stl, Layer_201_component_13.stl, Layer_201_component_14.stl]
2019-08-09 vacuum extension + target vacuum encompassing scattering chamber fix
2019-10-11 fixed material for vacuum
2019-12-11 non-working version of the BMT bonus variation
    [TargetAlWindowD.stl, TargetAlWindowU.stl, TargetBaseTubeTorlon.stl, TargetEndCapKapton.stl, TargetVacuumWindow50umAl.stl, TargetWallKapton.stl, TargetWindowAdapterTorlon.stl, foamExtended.stl]
2019-12-11 putting material routine inside the conf loop
2019-12-11 bonus variation for MM shifted back by 1.8 mm
    [micromegas__parameters_bonus.txt]
2019-12-13 Modifications of materials and geometry for BoNuS slim Micromegas version
    [micromegas__parameters_bonus.txt]
2019-12-18 bonus variation renamed to rgf_spring2020
    [micromegas__parameters_rgf_spring2020.txt]
2019-12-18 just comment
    [ftof__parameters_default.txt, ftof__parameters_rga_fall2018.txt]
2020-04-07 APOLLO target for RGC
    [InsertBath_NoVoid_6.stl]
2020-04-08 ELMO shield V1 no FT
    [DSShieldBackAss.stl, DSShieldBackCover.stl, DSShieldBackLead.stl, DSShieldFlange.stl, DSShieldFlangeAttachment.stl, DSShieldFrontAss.stl, DSShieldFrontCover.stl, DSShieldFrontLead.stl]
2020-05-18 magnet for polarized He3 target meshed using freecad, tessellation size: 0.2 mm surface deviation, standard method
    [MagnetPolHe3.stl]
2020-05-18 create a new directory for transversely polarized He3 target
    [InsertBath_NoVoid_6.stl, MagnetPolHe3.stl, TargetAlWindowD.stl, TargetAlWindowU.stl, TargetBaseTubeTorlon.stl, TargetEndCapKapton.stl, TargetFoam.stl, TargetFoam2.stl]
2020-05-20 add ttarget as target subsystem
    [InsertBath_NoVoid_6.stl, TargetAlWindowD.stl, TargetAlWindowU.stl, TargetBaseTubeTorlon.stl, TargetEndCapKapton.stl, TargetFoam.stl, TargetFoam2.stl, TargetFoam3.stl]
2020-07-02 ATOF and AHDC detector geometry for active cells, July 2020 by V. Sergeyeva
    [ahdc__parameters_default.txt, ahdc__parameters_rga_fall2018.txt, atof__parameters_default.txt, atof__parameters_rga_fall2018.txt, myatof__parameters_default.txt]
2020-07-21 nuclearTargetTest geo
    [TargetFoam.stl, TargetFoam2.stl, TargetFoam3.stl]
2020-07-22 added flux detector and finalized dimensions
    [TargetVacuumWindow50umAl.stl]
2020-07-26 upload all stl files for longitudinal target
    [MEOP_CLAS12.stp, al_window.stl, be.stl, beam_window.stl, deverter.stl, exchanger.stl, flow_entrance.stl, flow_entrance001.stl]
2020-07-26 target will be generated by gemc, not stl
    [he3.stl]
2020-07-27 adjust target location to -3 cm like rga-fall 2018
2020-07-27 create vacuum container around the target as mother volume, expect -3mm shift in z like as in rga fall 2018
2020-07-28 covering airgap to new scattering chamber configuration
2020-07-29 aluminium window by geometry.pl, no extension of mother volume, all daughter volumes enclosed by mother volume
    [al_window.stl, be.stl]
2020-07-30 use lH2's vacuum chamber
    [TargetFoam.stl, TargetFoam2.stl, TargetFoam3.stl, TargetVacuumWindow50umAl.stl, TargetWindowAdapterTorlon.stl]
2020-07-30 replace the approximate he3 part with the stl file
    [he3.stl]
2020-08-02 add root volume with magnetic field hdicefield
2020-08-06 MgB2 cylinder added, air pipe customized due to overlap
2020-08-15 modify hdIce up to current design
2020-09-03 update cad drawing of hdice
    [Target-for eHD-2015-12-22-for CLAS12 Simulation.stp, magnet.stl, target.stl, targetRing.stl, targetShellInner.stl, targetShellOuter.stl]
2020-09-03 replace target with stl file
2020-10-13 add ibc stl files, to be filtered later
2020-11-05 Removed band text files and added upstreamBeampipe.
    Conflicts:
    clas12/upstreamBeampipe/materials.pl
2020-12-21 hdIce target cad file updates
    [80KCan_Al.stl, 80KCan_SS.stl, LHeCan_Al.stl, LHeCan_Cu.stl, LHeCan_Nylon.stl, LHeCan_PCTFE.stl, LHeCan_SS.stl, Target-for eHD-2015-12-22-for CLAS12 Simulation.stp]
2021-01-19 bst bank def is inside variation loop
    [bst__parameters_java.txt, bst__parameters_original.txt]
2021-02-16 transverse target materials for rgh proposal
    [Transverse_target_for_simulation_20210212b.stp, cell.stl, ladder.stl, ladderSupport.stl, targetFrame.stl]
2021-02-18 transverse target geometry
    [Transverse_target_for_simulation.FCStd, Transverse_target_for_simulation.stp, Transverse_target_for_simulation_20210212b.stp, cell.stl]
2021-02-18 transverseTarget folder renamed include cad in name
    [Transverse_target_for_simulation.FCStd, Transverse_target_for_simulation.stp, downCoils.stl, downRing.stl, ladder.stl, ladderSupport.stl, magnetSupport.stl, targetFrame.stl]
2021-02-18 correct material and radii of transverse target
2021-02-22 transverse target correct materials
2021-02-24 material change in transverse target
2021-02-24 Update materials.pl
    Change bubble fluid from N2O to C3F8
2021-03-16 ALERT setup total geometryfor GEMC, 16 March 2021
    [atof__parameters_rga_fall2018.txt]
2021-03-29 one-piece scattering chamber and window position fix
    [TargetFoam.stl, TargetFoam2.stl, TargetFoam3.stl, scatteringChamber.stl]
2021-04-12 updated geometry of polarized target (APOLLO) and RG-C noFT (ELMO) Moller shield
    [InsertBath_NoVoid_6.stl]
2021-04-15 removed TargetWindowAdapterTorlon
    [TargetWindowAdapterTorlon.stl]
2021-06-30 size of mother to be a better envelope for the scattering chamber
2021-07-07 added beamline components
    [AdditionalWindows.FCStd, AdditionalWindows.stp, BeamPathExitWindow.stl, DownstreamRS.stl, InnerRSSheet.stl, InnerRSSheetMIR1.stl, Pumpline60mm.stl, UpstreamRS.stl]
2021-07-07 added materials in beam path for transverse field configuration. TransverseUpstreamBeampipe splitted in two to account for heat shield
    [AdditionalWindows.FCStd, AdditionalWindows.stp, BeamPathExitWindow.stl, DownstreamRS.stl, InnerRSSheet.stl, InnerRSSheetMIR1.stl, Pumpline60mm.stl, UpstreamRS.stl]
2021-08-19 New SLIM version for micromegas... Modified as well micromegas.pl to build bmt when slim version is called
    [micromegas__parameters_slim.txt]
2021-11-22 added mollerCup and entryDish for htcc
    [htccCone.stl, htccMollerCone.stl]
2021-11-23 added spring and fall2018 cad configurations
    [htccCone.stl, htccMollerCone.stl]
2021-12-09 added htcc moller cone extension, removed deprecated entry in elmo cad.gxml
    [htccMollerConeExt.stl]
2021-12-09 fixex htcc cad system of coordinates
2021-12-09 htcc cones with updated reference system
    [htccCone.stl, htccMollerCone.stl]
2022-02-18 added htcc entry / exit windows
    [htccCone.stl, htccMollerCone.stl, htccMollerConeExt.stl]
2022-02-18 added materials and entry exit windows. fixed positions of cad volumes
    [htccCone.stl, htccMollerCone.stl, htccMollerConeExt.stl]
2022-03-03 overlap fixes by Giovanni
    [RICH_s4.stl]
2022-03-16 removed upstream band material core file. updated band to include passive material. bank and hit updates for micromegas
2022-04-20 band bank for hipo and rich sector 4 cad.gxml was missing
2022-04-20 fixed missing bracket
2022-04-26 band gcard default output switched to hipo
2022-06-03 fixed ND3 target material and color
2022-06-29 fixed Cone2 Cylinder FTflangeShieldCylinder for rgh beamline
2022-07-25 erasing all txt files
    [ahdc__parameters_default.txt, ahdc__parameters_rga_fall2018.txt, atof__parameters_default.txt, atof__parameters_rga_fall2018.txt, myatof__parameters_default.txt]
2022-08-23 temp removing some cad import creating problems
    [BottomPlate.stl, Epoxy.stl, FrontPlate.stl, Mount.stl, NFrame.stl, Nose.stl, S1-BW.stl, S1-LW.stl]
2022-08-30 temp removed frame7
    [S1-TRB.stl]
2022-09-22 updated the geometry and materials of RG-F(BONuS12) RTPC and target variations
2022-10-14 Add cad target geometries specific to RG-M. Variation cadrgm removed upstream exit window and liquid target wall as not to conflict with solid target geometries.
    [TargetAlWindowU.stl, TargetBaseTubeTorlon.stl, TargetVacuumWindow50umAl.stl, scatteringChamber.stl]
2023-01-18 added volumes from cad
    [crystal_shell.stl, ddvcs_cal.FCStd, layout_calorimeter.stl, moeller_cone.stl]
2023-02-24 adding scatt chamber and target for ddvcs
2023-08-08 testing optics bug: stretched RICH_s4.stl in blender so that volume better contains optical components
    [RICH_s4.stl]
2023-08-08 fix overlap with ftof volume
    [RICH_s4.stl]
2023-08-14 Fixed the missing material of liquid Helium for the lHe target variation of the standard liquid target cell.
2023-08-21 Updated aerogel materials, now defined correctly for the two sectors + updated for sector 4
2023-08-25 define all mirror materials separately (currently all reflectivities the same, waiting for measurement tables from marco)
2023-10-20 native window cell, no cad
    [TargetAlWindowD.stl, TargetAlWindowU.stl]
2023-10-20 native scattering chamber cell, no cad
    [TargetVacuumWindow50umAl.stl]
2023-10-25 window placement from eng. numbers and adding additional barriers. mother target volume extended 8mm to accommodate for sc window
2023-10-25 moving scattering chamber 8mm upstream to play better with current airgap
2023-10-27 Some refactoring of geometry generation code to set number of sectors for each variation, rather than have a variation for each sector. New variations: default->two rich sectors, nominal positions; r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
2023-10-27 stop tracking rich_sector4
    [Aluminum.stl, CFRP.stl, Layer_201_component_1.stl, Layer_201_component_10.stl, Layer_201_component_11.stl, Layer_201_component_12.stl, Layer_201_component_13.stl, Layer_201_component_14.stl]
2023-11-02 fixed thicknesess of window materials
2023-11-08 Temporary change: copy corrected mother volume stl file stored in gemc instead of from coatjava
    [RICH_mother_corrected.stl]
2024-01-11 stl for target magnets
    [TGT-9000-1000-0000_MIRm.stl, TGT-9000-1000-0000m.stl, TGT-9000-1000-0001_MIR1m.stl, TGT-9000-1000-0001m.stl, TGT-9000-1000-0002_MIR1m.stl, TGT-9000-1000-0002m.stl, TGT-9000-1000-0003m.stl, TransverseMagnetForwardWedges.stp]
2024-01-11 cad gxml for transverseTargetMagnets variations
2024-03-19 Added the data files for ahdc
    [ahdc__parameters_default.txt, ahdc__parameters_rga_fall2018.txt]
2024-03-19 Added data files for atof
    [atof__parameters_default.txt, atof__parameters_rga_fall2018.txt]
2024-03-20 untracked all txt files - as they are supposed to be generated by the perl scripts.
    [ahdc__parameters_default.txt, ahdc__parameters_rga_fall2018.txt, atof__parameters_default.txt, atof__parameters_rga_fall2018.txt]
2024-04-12 Modified clas12/alert/ahdc/bank.pl to produce adc hits instead of tdc hits.
2024-04-16 Add aerogel Rayleigh scattering (scattering length from RICH aerogel passports) and aerogel roughness (currently tuning to angular resolution in data)
2024-04-16 planar mirrors now ground, specular spike probability 1.0 with some value for sigmaAlpha
2024-04-16 resolved an overlap between target and scattering chamber, created regular polycone to replace incomplete CAD beamline shield, updated gcard
2024-04-23 moved DSS (downstream shield) volumes from beamline to torus where the apex is implemented, updated ddvcs gcard
    [DSShieldBackAss.stl, DSShieldBackCover.stl, DSShieldBackLead.stl, DSShieldFlange.stl, DSShieldFlangeAttachment.stl, DSShieldFrontAss.stl, DSShieldFrontCover.stl, DSShieldFrontLead.stl]
2024-04-23 moved DSS (downstream shield) volumes from beamline to torus where the apex is implemented
    [DSShieldBackAss.stl, DSShieldBackCover.stl, DSShieldBackLead.stl, DSShieldFlange.stl, DSShieldFlangeAttachment.stl, DSShieldFrontAss.stl, DSShieldFrontCover.stl, DSShieldFrontLead.stl]
2024-05-17 Aerogel sigmaAlpha to 20 mrad (based on measurements pre-installation); First estimate of Mie scattering parameters, only forward scattering, 20% of photons scattered in 3cm aerogel, 1mrad average sc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
2024-05-19 Delete clas12/targets/README_EG2p
    It is not needed due to the change in flag assembly variations!
2024-05-19 Delete clas12/targets/EG2p directory
    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
    [cellAlwindow.stl, cellendcap.stl, endcapAlwindow.stl, firstRohacellSpacer.stl, firsttargframe.stl, secondRohacellSpacer.stl, secondtargframe.stl, targetContainer.stl]
2024-05-19 RG-D Flag Assembly Variations
    Updated with the geometry and variations of the RG-D flag assembly
    [eg2p_main_rode.stl, needle_1.stl, needle_2.stl, needle_3.stl, needle_4.stl]
2024-07-22 Make spherical mirrors ground
2024-08-14 added rge
    Added rge cad files in rge-dt directory, modified materials.pl and target.pl to include rge necessary geometries.
    [Aluminum.stl, Band.stl, Boxes.stl, Carbon.stl, Copper.stl, Lead.stl, Rings.stl, Rods.stl]
2024-08-21 geometry changes and variations
    Modify position of CAD files and geometry.pl to match engineering drawings. Now Al reference foil is located at 0. Changed other cad directory to common. Removed 2cm-lD2-empty variation. for empty the target use change material option.
    [ScatteringChamberC.stl, ScatteringChamberC_window.stl, TargetAlWindowD.stl, TargetAlWindowU.stl, TargetBaseTubeTorlon.stl, TargetEndCapKapton.stl, TargetWallKapton.stl]
2024-08-22 postition change and gcard added
    Moved everything target related 3 cm upstream. Center of solenoid magnetic field is located at -3cm in z axis. Previously I had the target positioned thinking the magnetic field was at 0 cm.
    Added draft of RGE gcard.
2024-08-23 typo correction in cad position
    typo -328.0*4mm -> -328.04*mm
2024-08-23 Update materials.pl
    changed name of available variations
2024-09-04 rge-bst shield update
    Added w51-rge variation to bstShield.pl with a slighter bigger radius, so it doesn't overlap the RGE carbon fiber scattering chamber. Removed bstShield from geometry.pl in the 2cm-lD2 variation part.
2024-09-04 Added 2cm empty liquid target variation
    Added 2cm-lD2-empty variation for RGE. Modified RGE gcards
2024-09-04 Change in liquid target windows
    For RGE, Changed CAD liquid target cell windows by geometries in geometry.pl by Maurizio recommendation. These new cylindrical windows have the correct 10 um width. Tweaked LD2 target to adjust to the new geometry.
    [TargetAlWindowD.stl, TargetAlWindowU.stl]
2024-09-11 saving progress
    [Apex_Shield_Lead_Fill.stl, Apex_Shield_PCAL_Hub.stl, Downstream_Beam_tube_Segment_1.stl, Torus_Beam_Tube_Reducer_2.stl, Torus_Exit_Shield_Casing.stl, Torus_Exit_Shield_Lead_Fill.stl, connectTorusToDownstreamPipe.stl, connectUpstreamToTorusPipe.stl]
2024-09-11 adjusted vacuum line to account for reducer
    [Downstream_Beam_tube_Segment_2.stl]
2024-09-12 adjusted cad volumes to address overlaps
    [Apex_Shield_Lead_Fill.stl, Apex_Shield_PCAL_Hub.stl, Downstream_Beam_tube_Segment_1.stl, Downstream_Beam_tube_Segment_2.stl, Torus_Beam_Tube_Reducer_2.stl, Torus_Exit_Shield_Casing.stl, Torus_Exit_Shield_Lead_Fill.stl, downstream_beamline.stp]
2024-10-02 Updated rge gcards
    Removed everything related to the forward carriage, the CND, the FT and the beamline and the magnets in the rge gcards. These gcards are for testing only.
2024-10-11 RGE overlapping fixes
    Modified RGE CAD slightly to remove overlapping and changed positions in .gxml files for the same reason.
    Moved all structure related CAD from all individual target directories to the common directory.
    [Band.stl, Rings.stl, Rods.stl, Tracks.stl]
2024-10-15 Disable local copy of mother STL file (updated version now included in coatjava)
2024-10-17 Add gcards for each current RICH variation; stop tracking outdated gcard.
2024-11-13 added sqlite factory for ftof, gcards, removed parameters because they are created at run time. removed obsolete geometry
    [ftof__parameters_default.txt, ftof__parameters_original.txt, ftof__parameters_rga_fall2018.txt]
2024-11-14 added micromegas__parameters_michel_9mmcopper.txt
    [micromegas__parameters_michel_9mmcopper.txt]
2024-11-18 adopting new cad import mechanism
    [htccCone.stl, htccMollerCone.stl, htccMollerConeExt.stl]
2024-11-26 standard readme and verified cad / mirror factories for htcc
2024-12-02 ltcc mods for new cad import, work in progress
    [ltcc__parameters_default.txt]
2024-12-03 ltcc variations renaming rgb_winter2019 to rgb_winter2020 and rgm to rgm_winter202. added text gcards. removed comments on previous gcards
    [WC_L.stl, WC_M.stl, WC_S.stl]
2024-12-04 moving cad to cad_default for gxml files. renaming hdIce to cad_hdice
    [80KCan_Al.stl, 80KCan_SS.stl, LHeCan_Al.stl, LHeCan_Cu.stl, LHeCan_Nylon.stl, LHeCan_PCTFE.stl, LHeCan_SS.stl, VacTube_SS.stl]
2024-12-05 rename target cad directories to a common cad prefix. target and magnets cad.gxml renamed cad_default.gxml
    [AdditionalWindows.FCStd, AdditionalWindows.stp, BeamPathExitWindow.stl, DownstreamRS.stl, InnerRSSheet.stl, InnerRSSheetMIR1.stl, InsertBath_NoVoid_6.stl, MEOP_CLAS12.stp]
2024-12-06 fixed lightguides overlaps and upstream positions. implementing new cad variations mechanism
2024-12-09 removed nuclearTargetTest. rich adapted to new cad import.
    [TargetFoam.stl, TargetFoam2.stl, TargetFoam3.stl, TargetVacuumWindow50umAl.stl]
2024-12-11 • cadBeamline, cadBeamlineFTOFF condensed to cad using new cad import
    [adjuster1.stl, adjuster2.stl, adjuster3.stl, cone-tip.stl, flange-assembly.stl, inner-assembly.stl, innerShieldAndFlange.stl, lead-shield.stl]
2024-12-11 cad_downstream_beamline condensed into cad
    [Apex_Shield_Lead_Fill.stl, Apex_Shield_PCAL_Hub.stl, Downstream_Beam_tube_Segment_1.stl, Downstream_Beam_tube_Segment_2.stl, Torus_Beam_Tube_Reducer_2.stl, Torus_Exit_Shield_Casing.stl, Torus_Exit_Shield_Lead_Fill.stl, downstream_beamline.stp]
2024-12-11 condensed cadBeamlineELMO into cad using new cad import
    [adjuster1.stl, adjuster2.stl, adjuster3.stl, innerShieldAndFlange.stl, main-cone.stl, nut1.stl, nut2.stl, nut3.stl]
2024-12-11 transverseTargetMagnets to cad_transverse using new cad import
    [TGT-9000-1000-0000_MIRm.stl, TGT-9000-1000-0000m.stl, TGT-9000-1000-0001_MIR1m.stl, TGT-9000-1000-0001m.stl, TGT-9000-1000-0002_MIR1m.stl, TGT-9000-1000-0002m.stl, TGT-9000-1000-0003m.stl, TransverseMagnetForwardWedges.stp]
2024-12-13 Geometry and materials for recoil detector (uRwell) for RGH (#259)
2024-12-16 dc fix for ddvcs and mm cu ground new test
2024-12-19 fixed case for lD2CuSn
2025-01-07 rename htcc original to default
    [htcc__parameters_default.txt]
2025-01-10 added gxml_to_sqlite.pl utility for geo service created gxml files . using SQLITE for ctof and its cads
    [ctof__parameters_default.txt]
2025-01-14 added cnd sqlite implementation and gcards
    [cnd__parameters_default.txt]
2025-01-30 Real run number simulation mods (#264)
    * adopting new cad import mechanism
    * removed obsolete files, updated readme for ec, pcal, dc, working on pcal geo / sqlite
    * added ftof readme and pcal verified sqlite
    * changed first run to 3029 following Carman email
    * variou readmes and added htcc gcards
    * added clas12_configuration_string.pm utility, used by htcc. using standard CLAS12 variation names for htcc
    * ddvcs fix
    * added shifts for entry and exit window. using sqlite factory for mirrors
    * standard readme and verified cad / mirror factories for htcc
    * removing default string from default variations as its now the default
    * ltcc mods for new cad import, work in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
    [80KCan_Al.stl, 80KCan_SS.stl, AdditionalWindows.FCStd, AdditionalWindows.stp, Apex_Shield_Lead_Fill.stl, Apex_Shield_PCAL_Hub.stl, BeamPathExitWindow.stl, DownstreamRS.stl]
2025-01-30 merging New cad import (#265)
    * ltcc mods for new cad import, work in progress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
2025-01-31 clas12 repo moved to clas12Tags
    [80KCan_Al.stl, 80KCan_SS.stl, AdditionalWindows.FCStd, AdditionalWindows.stp, Aluminum.stl, Apex_Shield_Lead_Fill.stl, Apex_Shield_PCAL_Hub.stl, Band.stl]
